biodigitalmatter/extruder_ctrl_circuits/24V_plc_integration_shield/shapes3D/SBCP-47HY101B.step

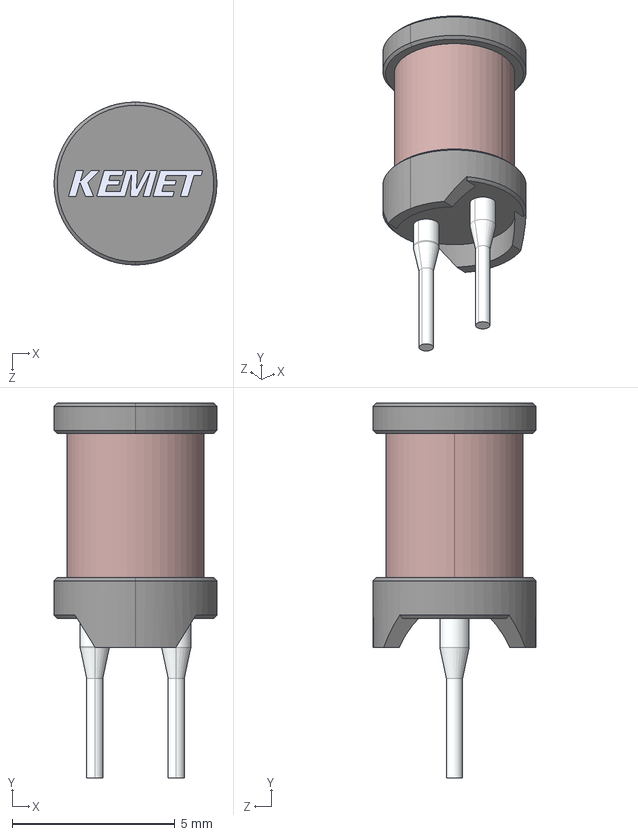
[picture p1: CAD file, 2022-01-20]
24V_plc_integration_shield/shapes3D/SBCP-47HY101B.step
5.00 x 11.5 x 5.00 mm
