biodigitalmatter/extruder_ctrl_circuits/24V_plc_integration_shield/shapes3D/R_Axial_DIN0207_L6.3mm_D2.5mm_P15.24mm_Horizontal.step

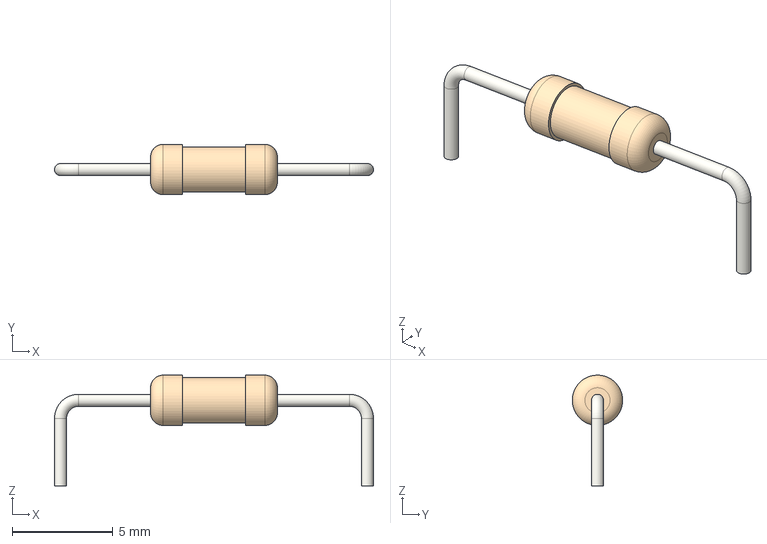
[picture p2: CAD file, 2022-01-13]
24V_plc_integration_shield/shapes3D/R_Axial_DIN0207_L6.3mm_D2.5mm_P15.24mm_Horizontal.step
15.8 x 2.50 x 5.50 mm
