biodigitalmatter/extruder_ctrl_circuits/24V_plc_integration_shield/shapes3D/DIP-6_W7.62mm.step

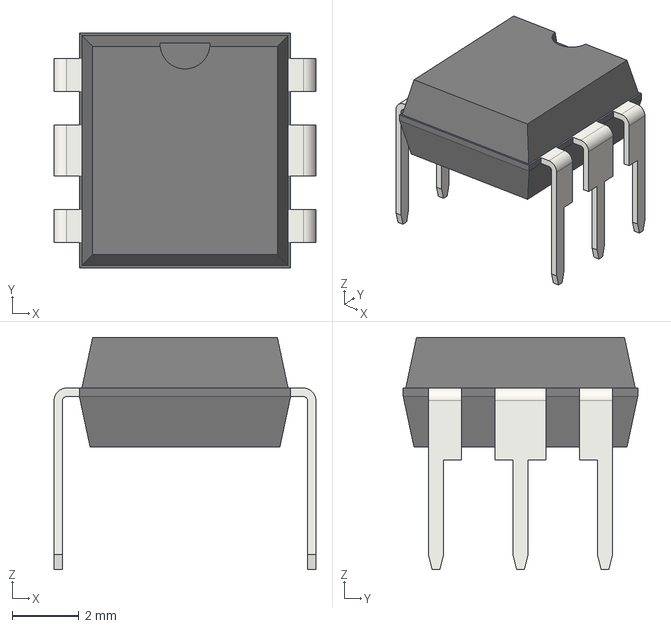
[picture p3: CAD file, 2022-01-13]
24V_plc_integration_shield/shapes3D/DIP-6_W7.62mm.step
7.87 x 7.05 x 6.98 mm
