biodigitalmatter/extruder_ctrl_circuits/24V_plc_integration_shield/shapes3D/R-78B5.0-1.0.STEP

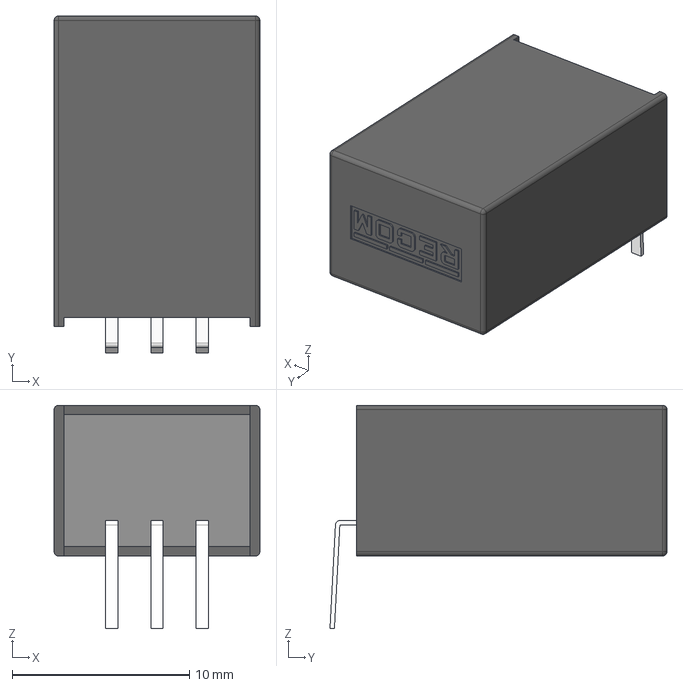
[picture p4: CAD file, 2021-12-29]
24V_plc_integration_shield/shapes3D/R-78B5.0-1.0.STEP
11.6 x 19.0 x 12.6 mm
