biodigitalmatter/extruder_ctrl_circuits/24V_plc_integration_shield/shapes3D/CP_Radial_D6.3mm_P2.50mm.step

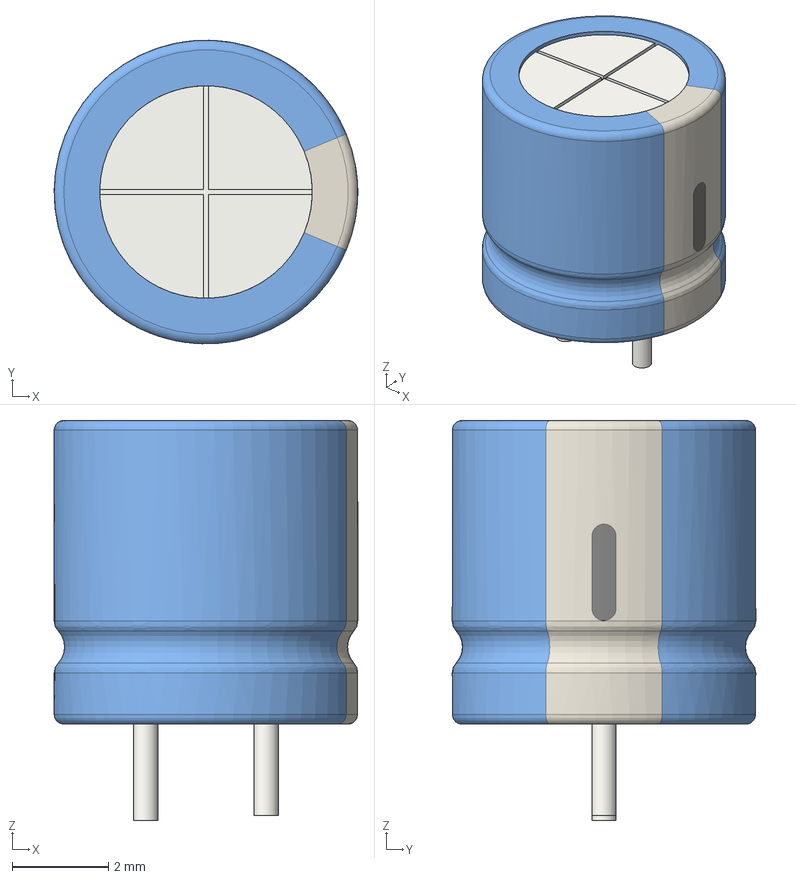
[picture p5: CAD file, 2021-11-03]
24V_plc_integration_shield/shapes3D/CP_Radial_D6.3mm_P2.50mm.step
6.30 x 6.30 x 8.30 mm
