biodigitalmatter/extruder_ctrl_circuits/24V_plc_integration_shield/shapes3D/1776275-2.step

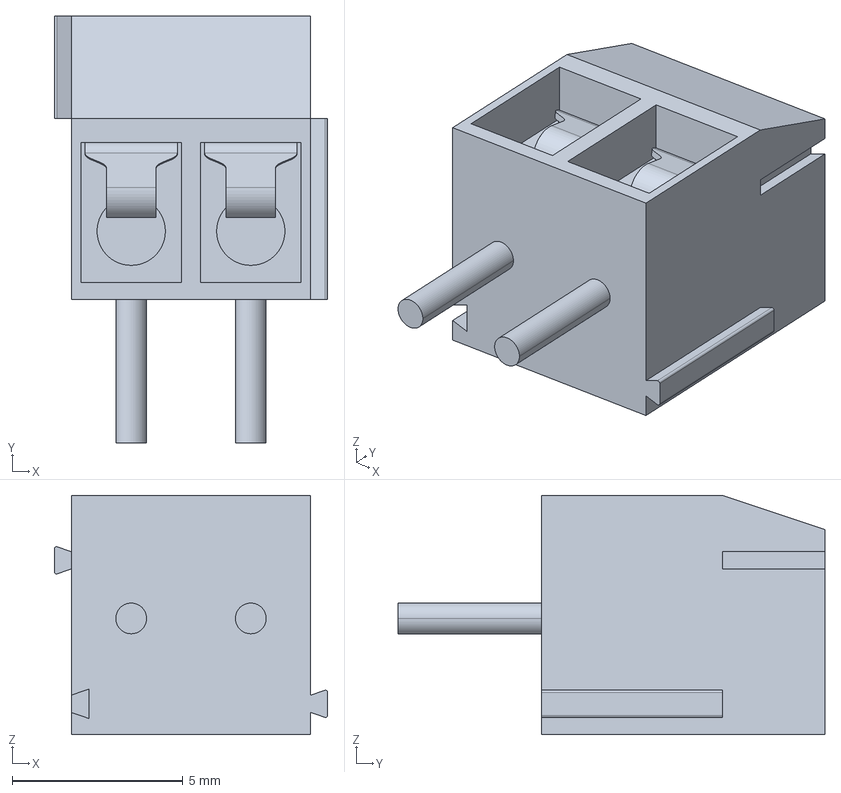
[picture p6: CAD file, 2022-01-13]
24V_plc_integration_shield/shapes3D/1776275-2.step
8.00 x 12.5 x 7.00 mm
