biodigitalmatter/extruder_ctrl_circuits/24V_plc_integration_shield/shapes3D/105450-0101.step

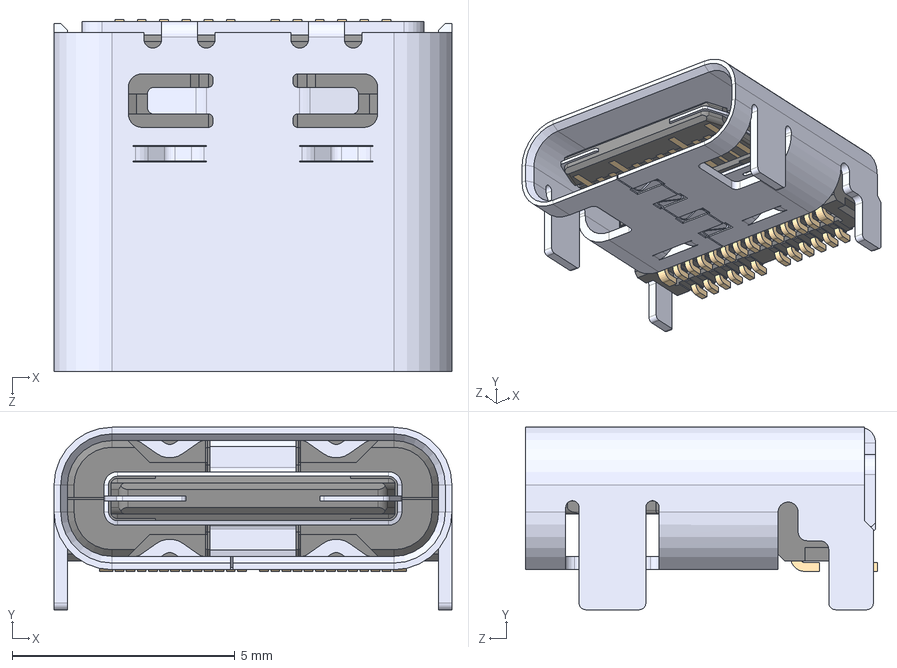
[picture p7: CAD file, 2022-01-05]
24V_plc_integration_shield/shapes3D/105450-0101.step
8.94 x 4.10 x 7.90 mm
