biodigitalmatter/extruder_ctrl_circuits/24V_plc_integration_shield/shapes3D/430450600.STEP

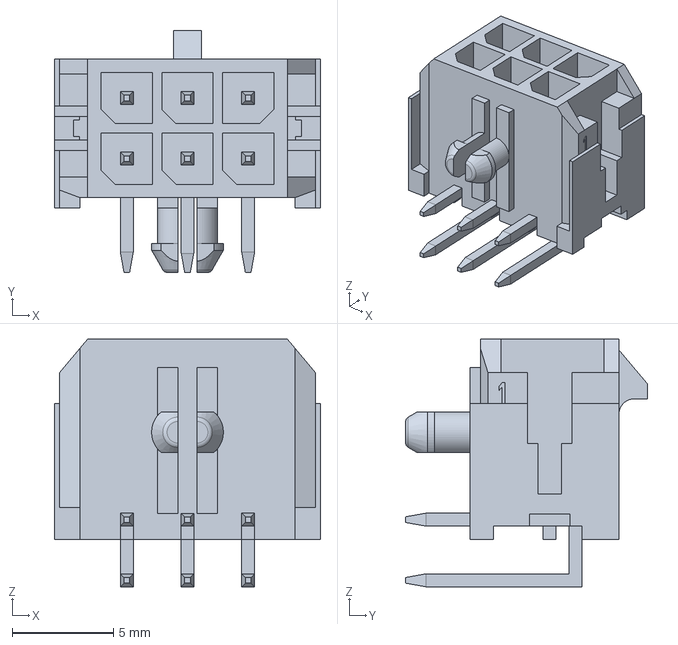
[picture p8: CAD file, 2021-12-29]
24V_plc_integration_shield/shapes3D/430450600.STEP
13.2 x 11.9 x 12.2 mm
