biodigitalmatter/extruder_ctrl_circuits/24V_plc_integration_shield/shapes3D/430450400.STEP

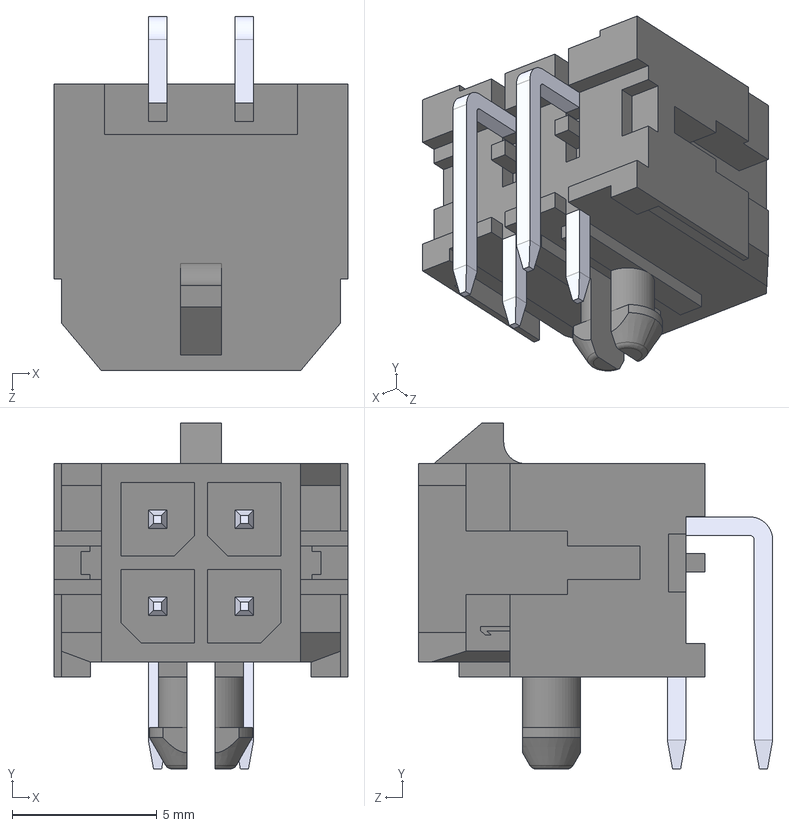
[picture p9: CAD file, 2021-12-29]
24V_plc_integration_shield/shapes3D/430450400.STEP
10.2 x 12.0 x 12.2 mm
