biodigitalmatter/extruder_ctrl_circuits/(commit log)

2021-10-28 First upload
    [DIP-6_W7.62mm.step, R_Axial_DIN0207_L6.3mm_D2.5mm_P15.24mm_Horizontal.step, extruder_controll.kicad_pcb, extruder_controll.sch]
2021-10-28 cleaned up and pcb ready
    [extruder_controll.kicad_pcb, extruder_controll.sch]
2021-10-29 wider tracks and more clearance
    [extruder_controll.kicad_pcb]
2021-11-01 hierarchical sheets
    [24V-signal-to-5V.sch, extruder_controll.kicad_pcb, extruder_controll.sch]
2021-11-02 logo and compact
    [extruder_controll.kicad_pcb]
2021-11-03 rearchived incl footprints, some connector wiring changed
    [24V-signal-to-5V.sch, CP_Radial_D6.3mm_P2.50mm.step, extruder_controll.kicad_pcb, extruder_controll.sch]
2021-12-29 made into a shield. needs cleaning up and 2nd opinion
    [24V-signal-to-5V.sch, 430450400.STEP, 430450600.STEP, R-78B5.0-1.0.STEP, extruder_controll.kicad_pcb, extruder_controll.sch]
2022-01-04 test use archive in v6
    [24V-signal-to-5V.kicad_sch, extruder_controll.kicad_sch, extruder_controll.step]
2022-01-04 test archiving but using default lib
    [24V-signal-to-5V.kicad_sch, extruder_controll.kicad_pcb, extruder_controll.kicad_sch]
2022-01-05 components in place
    [105450-0101.step, 24V-signal-to-5V.kicad_sch, extruder_controll.kicad_pcb, extruder_controll.kicad_sch]
2022-01-13 big commit after big mistake
    [105450-0101.step, 1776275-2.step, 24V-signal-to-5V.sch, 24V_plc_integration_shield.kicad_pcb, 24V_plc_integration_shield.kicad_sch, 24V_plc_integration_shield.step, 24V_signal_to_5V.kicad_sch, 430450400.STEP]
2022-01-14 lingering update
    [24V_plc_integration_shield.kicad_pcb]
2022-01-14 mostly wired up
    [24V_plc_integration_shield.kicad_pcb, 24V_plc_integration_shield.kicad_sch, 24V_signal_to_5V.kicad_sch]
2022-01-15 ready for fab?
    [24V_plc_integration_shield.kicad_pcb, 24V_plc_integration_shield.kicad_sch, 24V_signal_to_5V.kicad_sch]
2022-01-18 updates after review by alexander
    [24V_plc_integration_shield.kicad_pcb, 24V_plc_integration_shield.kicad_sch, 24V_signal_to_5V.kicad_sch]
2022-01-20 proper footprint for inductor
    [24V_plc_integration_shield.kicad_pcb, 24V_plc_integration_shield.kicad_sch, 24V_signal_to_5V.kicad_sch, SBCP-47HY101B.step]
2022-01-21 cleanup schematic
    [24V_plc_integration_shield.kicad_sch, 24V_signal_to_5V.kicad_sch]
2022-01-21 add checks and move all boardpage stuff to .github
2022-01-21 put back paths to sch and pcb
2022-01-26 added ordering information to symbols
    [24V_plc_integration_shield.kicad_pcb, 24V_plc_integration_shield.kicad_sch, 24V_signal_to_5V.kicad_sch]
2022-02-11 changed footprint to have cuts
    [24V_plc_integration_shield.step]
2022-03-15 fix error in schematic dc/dc
    [24V_plc_integration_shield.kicad_pcb, 24V_plc_integration_shield.kicad_sch, 24V_signal_to_5V.kicad_sch, power.kicad_sch]
2022-03-17 4 layer design
    [24V_plc_integration_shield.kicad_pcb, 24V_plc_integration_shield.kicad_sch, power.kicad_sch]
2022-03-23 pcb v3 presentation ready
    [24V_plc_integration_shield.kicad_pcb, 24V_plc_integration_shield.kicad_sch, 24V_signal_to_5V.kicad_sch, power.kicad_sch]
2022-03-24 debug ref field on schematic
2022-04-04 added part details for smd led
    [24V_plc_integration_shield.kicad_pcb, 24V_plc_integration_shield.kicad_sch, 24V_signal_to_5V.kicad_sch, power.kicad_sch]
2023-06-05 document whole setup
    [complete_setup.kicad_pcb, complete_setup.kicad_sch]
