biodigitalmatter/extruder_ctrl_circuits/(notices)

Notices in the files:
24V_plc_integration_shield/shapes3D/CP_Radial_D6.3mm_P2.50mm.step:
Copyright (C) 2017, kicad StepUp
This program is free software: you can redistribute it and/or modify
it under the terms of the GNU General Public License as published by
the Free Software Foundation, either version 3 of the License, or
any later version.
itself might be covered by the GNU General Public License.
24V_plc_integration_shield/shapes3D/R_Axial_DIN0207_L6.3mm_D2.5mm_P15.24mm_Horizontal.step:
This work is licensed under the [Creative Commons CC-BY-SA 4.0 License](https://creativecommons.org/licenses/by-sa/4.0/legalcode),
with the following exception:
To the extent that the creation of electronic designs that use 'Licensed Material' can be considered to be 'Adapted Material',
You are free to use the library data in your own projects without the obligation to share your project files under this or any other license agreement.
24V_plc_integration_shield/shapes3D/DIP-6_W7.62mm.step:
Copyright (C) 2017, your name
